tinyfab/HeatbedControlFW/TFHBCTRLV1_R1.pdf

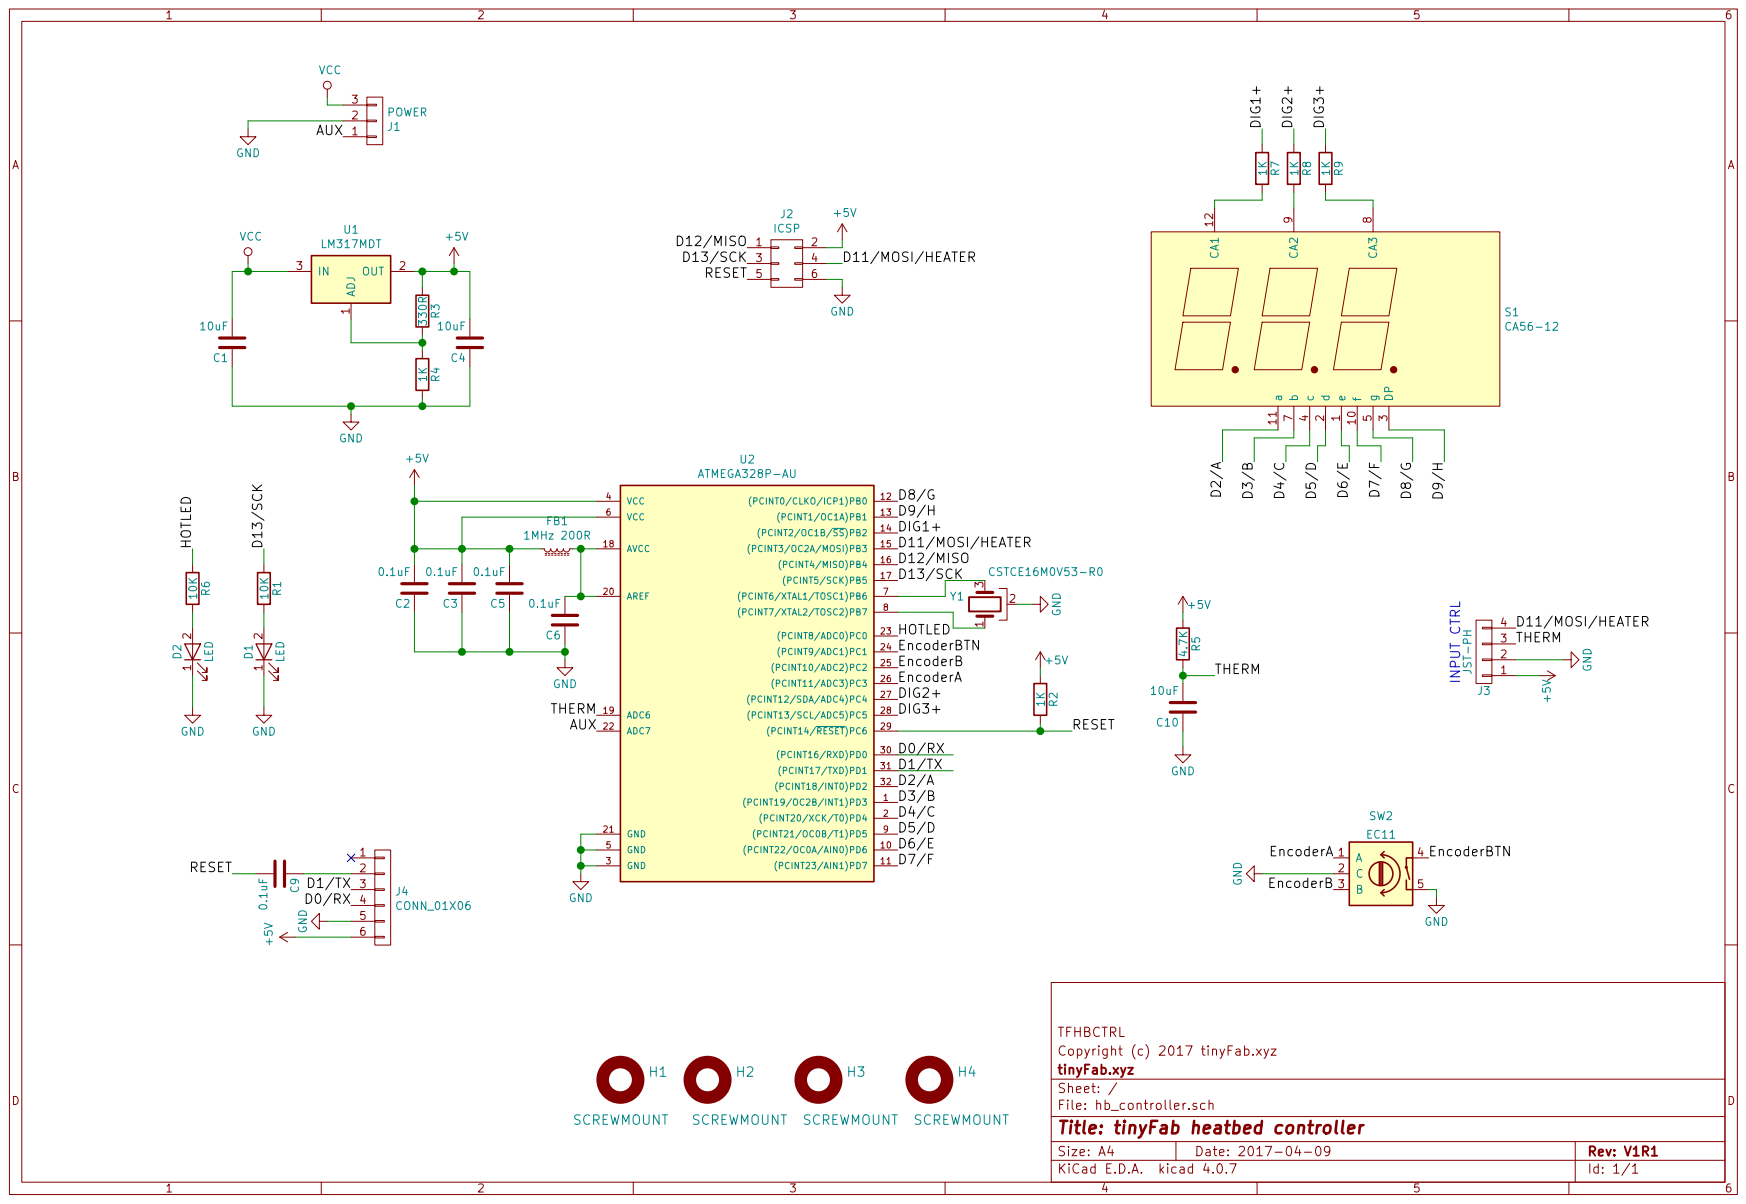
[picture p1: page 1]
