tinyfab/HeatbedControlFW/TFHBMOSV1_R1.pdf

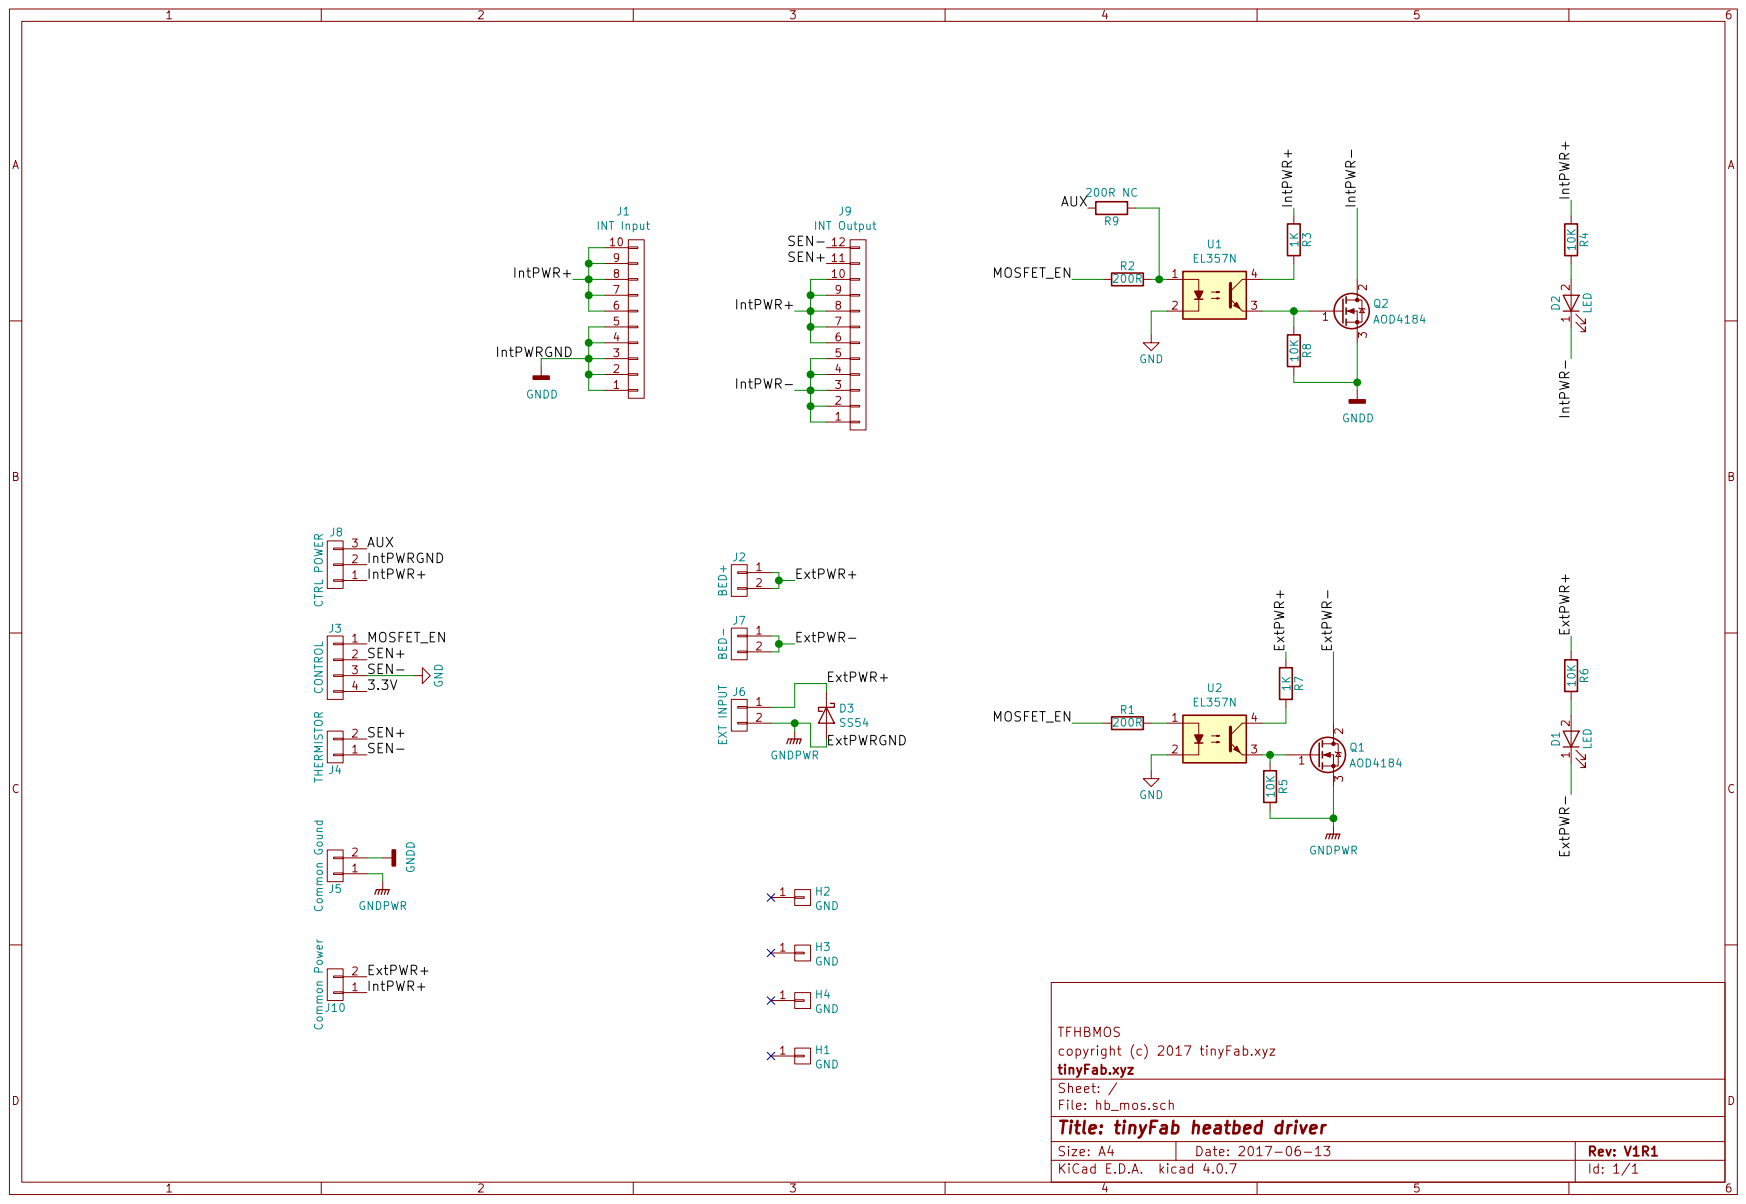
[picture p2: page 1]
