tinyfab/HeatbedControlFW/(commit log)

2017-06-24 decrease brightness save power
2017-06-30 limit to 9h60min timer
2017-07-04 pin out to match V1R1 Release V1.00
2017-11-03 added schematic
